psychogenic/analogmuxkit/docs/images/passgates_rdson.png

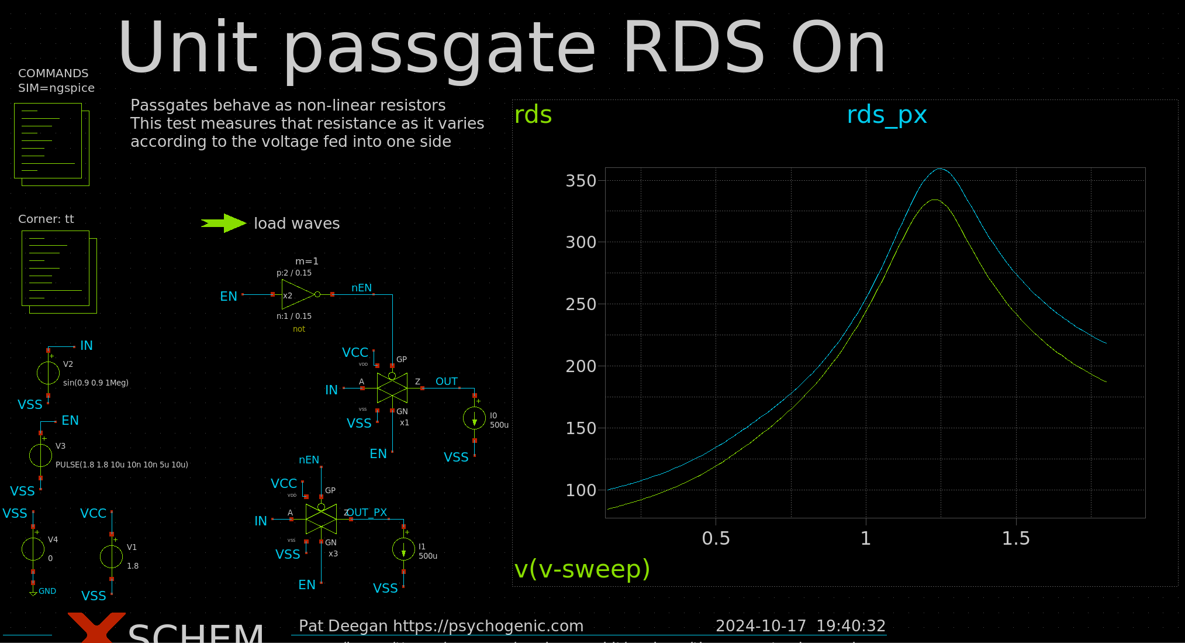
docs/images/passgates_rdson.png
