psychogenic/analogmuxkit/xschem/extracted/mux4onehot_parax.spice

* NGSPICE file created from mux4onehot_parax.ext - technology: sky130A

.subckt mux4onehot_parax select1 select2 A1 A3 Z1 A2 A4 select0 Z4 Z3 VDD Z2 VSS nselect2
X0 A2.t1 x2.GP2.t4 Z2.t1 VDD.t13 sky130_fd_pr__pfet_01v8_lvt ad=2.9 pd=20.58 as=2.9 ps=20.58 w=10 l=0.35
X1 VDD.t65 a_5275_n4059# a_5275_n4235# VDD.t64 sky130_fd_pr__pfet_01v8_hvt ad=0.0714 pd=0.76 as=0.0609 ps=0.71 w=0.42 l=0.15
X2 A1.t2 x2.GP1.t4 Z1.t2 VDD.t18 sky130_fd_pr__pfet_01v8_lvt ad=2.9 pd=20.58 as=2.9 ps=20.58 w=10 l=0.35
X3 VSS.t65 select0.t0 a_5275_n3507# VSS.t64 sky130_fd_pr__nfet_01v8 ad=0.1092 pd=1.36 as=0.1092 ps=1.36 w=0.42 l=0.15
X4 a_5275_n3683# a_5275_n3507# a_5301_n3555# VSS.t18 sky130_fd_pr__nfet_01v8 ad=0.1092 pd=1.36 as=0.0504 ps=0.66 w=0.42 l=0.15
X5 A4.t2 x2.GP4.t4 Z4.t2 VDD.t30 sky130_fd_pr__pfet_01v8_lvt ad=2.9 pd=20.58 as=2.9 ps=20.58 w=10 l=0.35
X6 VSS.t9 select1.t0 x1.nSEL1 VSS.t8 sky130_fd_pr__nfet_01v8 ad=0.169 pd=1.82 as=0.08775 ps=0.92 w=0.65 l=0.15
X7 VSS.t31 x2.GN2 x2.GP2.t2 VSS.t30 sky130_fd_pr__nfet_01v8 ad=0.169 pd=1.82 as=0.08775 ps=0.92 w=0.65 l=0.15
X8 x1.nSEL0 select0.t1 VSS.t63 VSS.t62 sky130_fd_pr__nfet_01v8 ad=0.08775 pd=0.92 as=0.169 ps=1.82 w=0.65 l=0.15
X9 VSS.t15 a_5275_n4651# x2.GN1.t0 VSS.t14 sky130_fd_pr__nfet_01v8 ad=0.1118 pd=1.04 as=0.182 ps=1.86 w=0.65 l=0.15
X10 VDD.t17 select0.t2 x1.nSEL0 VDD.t16 sky130_fd_pr__pfet_01v8_hvt ad=0.26 pd=2.52 as=0.135 ps=1.27 w=1 l=0.15
X11 x2.GP1.t2 x2.GN1.t2 VSS.t2 VSS.t1 sky130_fd_pr__nfet_01v8 ad=0.08775 pd=0.92 as=0.169 ps=1.82 w=0.65 l=0.15
X12 VSS.t25 x2.GN1.t3 x2.GP1.t3 VSS.t24 sky130_fd_pr__nfet_01v8 ad=0.169 pd=1.82 as=0.08775 ps=0.92 w=0.65 l=0.15
X13 x2.GP4.t1 x2.GN4.t2 VDD.t22 VDD.t21 sky130_fd_pr__pfet_01v8_hvt ad=0.135 pd=1.27 as=0.26 ps=2.52 w=1 l=0.15
X14 VDD.t15 x2.GN4.t3 x2.GP4.t0 VDD.t14 sky130_fd_pr__pfet_01v8_hvt ad=0.26 pd=2.52 as=0.135 ps=1.27 w=1 l=0.15
X15 a_5275_n4059# select1.t1 VDD.t2 VDD.t1 sky130_fd_pr__pfet_01v8_hvt ad=0.1092 pd=1.36 as=0.0714 ps=0.76 w=0.42 l=0.15
X16 VSS.t49 VDD.t71 VSS.t48 VSS.t47 sky130_fd_pr__nfet_01v8 ad=0.143 pd=1.62 as=0 ps=0 w=0.55 l=1.05
X17 a_5301_n4107# select0.t3 VSS.t61 VSS.t60 sky130_fd_pr__nfet_01v8 ad=0.0504 pd=0.66 as=0.1013 ps=0.99 w=0.42 l=0.15
X18 VSS.t13 a_5275_n4235# x2.GN2 VSS.t12 sky130_fd_pr__nfet_01v8 ad=0.1013 pd=0.99 as=0.169 ps=1.82 w=0.65 l=0.15
X19 a_5275_n4651# x1.nSEL1 VDD.t27 VDD.t26 sky130_fd_pr__pfet_01v8_hvt ad=0.0567 pd=0.69 as=0.16655 ps=1.39 w=0.42 l=0.15
X20 VSS.t46 VDD.t72 VSS.t45 VSS.t44 sky130_fd_pr__nfet_01v8 ad=0.143 pd=1.62 as=0 ps=0 w=0.55 l=1.05
X21 a_5275_n3507# select0.t4 VDD.t44 VDD.t43 sky130_fd_pr__pfet_01v8_hvt ad=0.1092 pd=1.36 as=0.0714 ps=0.76 w=0.42 l=0.15
X22 a_5275_n4235# select0.t5 VDD.t52 VDD.t51 sky130_fd_pr__pfet_01v8_hvt ad=0.0609 pd=0.71 as=0.2279 ps=1.74 w=0.42 l=0.15
X23 VDD.t54 x1.nSEL0 a_5275_n4651# VDD.t53 sky130_fd_pr__pfet_01v8_hvt ad=0.1176 pd=1.4 as=0.0567 ps=0.69 w=0.42 l=0.15
X24 VDD.t34 a_5275_n3507# a_5275_n3683# VDD.t33 sky130_fd_pr__pfet_01v8_hvt ad=0.0714 pd=0.76 as=0.0609 ps=0.71 w=0.42 l=0.15
X25 VDD.t42 a_5275_n3683# x2.GN3 VDD.t41 sky130_fd_pr__pfet_01v8_hvt ad=0.2279 pd=1.74 as=0.26 ps=2.52 w=1 l=0.15
X26 VSS.t67 a_5275_n2995# x2.GN4.t0 VSS.t66 sky130_fd_pr__nfet_01v8 ad=0.1118 pd=1.04 as=0.182 ps=1.86 w=0.65 l=0.15
X27 nselect2.t3 select2.t0 VDD.t36 VDD.t35 sky130_fd_pr__pfet_01v8_hvt ad=0.135 pd=1.27 as=0.26 ps=2.52 w=1 l=0.15
X28 A3.t1 x2.GP3 Z3.t1 VDD.t0 sky130_fd_pr__pfet_01v8_lvt ad=2.9 pd=20.58 as=2.9 ps=20.58 w=10 l=0.35
X29 VSS.t59 select0.t6 x1.nSEL0 VSS.t58 sky130_fd_pr__nfet_01v8 ad=0.169 pd=1.82 as=0.08775 ps=0.92 w=0.65 l=0.15
X30 Z3.t3 x2.GN3 A3.t3 VSS.t7 sky130_fd_pr__nfet_01v8_lvt ad=2.32 pd=16.58 as=2.32 ps=16.58 w=8 l=0.35
X31 Z3.t2 x2.GN3 A3.t2 VSS.t7 sky130_fd_pr__nfet_01v8_lvt ad=2.32 pd=16.58 as=2.32 ps=16.58 w=8 l=0.35
X32 VDD.t40 select2.t1 nselect2.t2 VDD.t39 sky130_fd_pr__pfet_01v8_hvt ad=0.26 pd=2.52 as=0.135 ps=1.27 w=1 l=0.15
X33 x2.GP4.t3 x2.GN4.t4 VSS.t55 VSS.t54 sky130_fd_pr__nfet_01v8 ad=0.08775 pd=0.92 as=0.169 ps=1.82 w=0.65 l=0.15
X34 x2.GP3 x2.GN3 VDD.t12 VDD.t11 sky130_fd_pr__pfet_01v8_hvt ad=0.135 pd=1.27 as=0.26 ps=2.52 w=1 l=0.15
X35 x1.nSEL1 select1.t2 VDD.t4 VDD.t3 sky130_fd_pr__pfet_01v8_hvt ad=0.135 pd=1.27 as=0.26 ps=2.52 w=1 l=0.15
X36 x2.GP2.t0 x2.GN2 VDD.t58 VDD.t57 sky130_fd_pr__pfet_01v8_hvt ad=0.135 pd=1.27 as=0.26 ps=2.52 w=1 l=0.15
X37 VDD.t25 VSS.t68 VDD.t24 VDD.t23 sky130_fd_pr__pfet_01v8_hvt ad=0.2262 pd=2.26 as=0 ps=0 w=0.87 l=1.05
X38 VSS.t17 x2.GN4.t5 x2.GP4.t2 VSS.t16 sky130_fd_pr__nfet_01v8 ad=0.169 pd=1.82 as=0.08775 ps=0.92 w=0.65 l=0.15
X39 VSS.t43 VDD.t73 VSS.t42 VSS.t41 sky130_fd_pr__nfet_01v8 ad=0.143 pd=1.62 as=0 ps=0 w=0.55 l=1.05
X40 a_5329_n4513# x1.nSEL1 VSS.t11 VSS.t10 sky130_fd_pr__nfet_01v8 ad=0.0567 pd=0.69 as=0.1118 ps=1.04 w=0.42 l=0.15
X41 VDD.t61 VSS.t69 VDD.t60 VDD.t59 sky130_fd_pr__pfet_01v8_hvt ad=0.2262 pd=2.26 as=0 ps=0 w=0.87 l=1.05
X42 a_5275_n4651# x1.nSEL0 a_5329_n4513# VSS.t26 sky130_fd_pr__nfet_01v8 ad=0.1176 pd=1.4 as=0.0567 ps=0.69 w=0.42 l=0.15
X43 A4.t1 x2.GP4.t5 Z4.t1 VDD.t30 sky130_fd_pr__pfet_01v8_lvt ad=2.9 pd=20.58 as=2.9 ps=20.58 w=10 l=0.35
X44 a_5275_n2995# select0.t7 VDD.t38 VDD.t37 sky130_fd_pr__pfet_01v8_hvt ad=0.0567 pd=0.69 as=0.16655 ps=1.39 w=0.42 l=0.15
X45 VDD.t10 x2.GN3 x2.GP3 VDD.t9 sky130_fd_pr__pfet_01v8_hvt ad=0.26 pd=2.52 as=0.135 ps=1.27 w=1 l=0.15
X46 VDD.t32 a_5275_n4651# x2.GN1.t1 VDD.t31 sky130_fd_pr__pfet_01v8_hvt ad=0.16655 pd=1.39 as=0.475 ps=2.95 w=1 l=0.15
X47 Z4.t0 x2.GN4.t6 A4.t0 VSS.t19 sky130_fd_pr__nfet_01v8_lvt ad=2.32 pd=16.58 as=2.32 ps=16.58 w=8 l=0.35
X48 VSS.t40 VDD.t74 VSS.t39 VSS.t38 sky130_fd_pr__nfet_01v8 ad=0.143 pd=1.62 as=0 ps=0 w=0.55 l=1.05
X49 Z4.t3 x2.GN4.t7 A4.t3 VSS.t19 sky130_fd_pr__nfet_01v8_lvt ad=2.32 pd=16.58 as=2.32 ps=16.58 w=8 l=0.35
X50 VDD.t20 select1.t3 a_5275_n2995# VDD.t19 sky130_fd_pr__pfet_01v8_hvt ad=0.1176 pd=1.4 as=0.0567 ps=0.69 w=0.42 l=0.15
X51 a_5275_n3683# select1.t4 VDD.t47 VDD.t9 sky130_fd_pr__pfet_01v8_hvt ad=0.0609 pd=0.71 as=0.2279 ps=1.74 w=0.42 l=0.15
X52 nselect2.t1 select2.t2 VSS.t53 VSS.t52 sky130_fd_pr__nfet_01v8 ad=0.08775 pd=0.92 as=0.169 ps=1.82 w=0.65 l=0.15
X53 a_5275_n4235# a_5275_n4059# a_5301_n4107# VSS.t36 sky130_fd_pr__nfet_01v8 ad=0.1092 pd=1.36 as=0.0504 ps=0.66 w=0.42 l=0.15
X54 VSS.t51 select2.t3 nselect2.t0 VSS.t50 sky130_fd_pr__nfet_01v8 ad=0.169 pd=1.82 as=0.08775 ps=0.92 w=0.65 l=0.15
X55 x2.GP3 x2.GN3 VSS.t6 VSS.t5 sky130_fd_pr__nfet_01v8 ad=0.08775 pd=0.92 as=0.169 ps=1.82 w=0.65 l=0.15
X56 VDD.t50 VSS.t70 VDD.t49 VDD.t48 sky130_fd_pr__pfet_01v8_hvt ad=0.2262 pd=2.26 as=0 ps=0 w=0.87 l=1.05
X57 A2.t0 x2.GP2.t5 Z2.t0 VDD.t13 sky130_fd_pr__pfet_01v8_lvt ad=2.9 pd=20.58 as=2.9 ps=20.58 w=10 l=0.35
X58 VDD.t46 select1.t5 x1.nSEL1 VDD.t45 sky130_fd_pr__pfet_01v8_hvt ad=0.26 pd=2.52 as=0.135 ps=1.27 w=1 l=0.15
X59 x1.nSEL1 select1.t6 VSS.t35 VSS.t34 sky130_fd_pr__nfet_01v8 ad=0.08775 pd=0.92 as=0.169 ps=1.82 w=0.65 l=0.15
X60 x2.GP2.t3 x2.GN2 VSS.t29 VSS.t28 sky130_fd_pr__nfet_01v8 ad=0.08775 pd=0.92 as=0.169 ps=1.82 w=0.65 l=0.15
X61 VDD.t29 a_5275_n4235# x2.GN2 VDD.t28 sky130_fd_pr__pfet_01v8_hvt ad=0.2279 pd=1.74 as=0.26 ps=2.52 w=1 l=0.15
X62 Z2.t2 x2.GN2 A2.t3 VSS.t27 sky130_fd_pr__nfet_01v8_lvt ad=2.32 pd=16.58 as=2.32 ps=16.58 w=8 l=0.35
X63 a_5329_n2857# select0.t8 VSS.t57 VSS.t56 sky130_fd_pr__nfet_01v8 ad=0.0567 pd=0.69 as=0.1118 ps=1.04 w=0.42 l=0.15
X64 A1.t1 x2.GP1.t5 Z1.t1 VDD.t18 sky130_fd_pr__pfet_01v8_lvt ad=2.9 pd=20.58 as=2.9 ps=20.58 w=10 l=0.35
X65 Z2.t3 x2.GN2 A2.t2 VSS.t27 sky130_fd_pr__nfet_01v8_lvt ad=2.32 pd=16.58 as=2.32 ps=16.58 w=8 l=0.35
X66 VDD.t70 a_5275_n2995# x2.GN4.t1 VDD.t69 sky130_fd_pr__pfet_01v8_hvt ad=0.16655 pd=1.39 as=0.475 ps=2.95 w=1 l=0.15
X67 VDD.t68 VSS.t71 VDD.t67 VDD.t66 sky130_fd_pr__pfet_01v8_hvt ad=0.2262 pd=2.26 as=0 ps=0 w=0.87 l=1.05
X68 VSS.t4 x2.GN3 x2.GP3 VSS.t3 sky130_fd_pr__nfet_01v8 ad=0.169 pd=1.82 as=0.08775 ps=0.92 w=0.65 l=0.15
X69 VDD.t56 x2.GN2 x2.GP2.t1 VDD.t55 sky130_fd_pr__pfet_01v8_hvt ad=0.26 pd=2.52 as=0.135 ps=1.27 w=1 l=0.15
X70 x1.nSEL0 select0.t9 VDD.t63 VDD.t62 sky130_fd_pr__pfet_01v8_hvt ad=0.135 pd=1.27 as=0.26 ps=2.52 w=1 l=0.15
X71 Z1.t3 x2.GN1.t4 A1.t3 VSS.t0 sky130_fd_pr__nfet_01v8_lvt ad=2.32 pd=16.58 as=2.32 ps=16.58 w=8 l=0.35
X72 x2.GP1.t1 x2.GN1.t5 VDD.t8 VDD.t7 sky130_fd_pr__pfet_01v8_hvt ad=0.135 pd=1.27 as=0.26 ps=2.52 w=1 l=0.15
X73 Z1.t0 x2.GN1.t6 A1.t0 VSS.t0 sky130_fd_pr__nfet_01v8_lvt ad=2.32 pd=16.58 as=2.32 ps=16.58 w=8 l=0.35
X74 a_5275_n2995# select1.t7 a_5329_n2857# VSS.t37 sky130_fd_pr__nfet_01v8 ad=0.1176 pd=1.4 as=0.0567 ps=0.69 w=0.42 l=0.15
X75 a_5301_n3555# select1.t8 VSS.t23 VSS.t22 sky130_fd_pr__nfet_01v8 ad=0.0504 pd=0.66 as=0.1013 ps=0.99 w=0.42 l=0.15
X76 VSS.t21 a_5275_n3683# x2.GN3 VSS.t20 sky130_fd_pr__nfet_01v8 ad=0.1013 pd=0.99 as=0.169 ps=1.82 w=0.65 l=0.15
X77 VSS.t33 select1.t9 a_5275_n4059# VSS.t32 sky130_fd_pr__nfet_01v8 ad=0.1092 pd=1.36 as=0.1092 ps=1.36 w=0.42 l=0.15
X78 VDD.t6 x2.GN1.t7 x2.GP1.t0 VDD.t5 sky130_fd_pr__pfet_01v8_hvt ad=0.26 pd=2.52 as=0.135 ps=1.27 w=1 l=0.15
X79 A3.t0 x2.GP3 Z3.t0 VDD.t0 sky130_fd_pr__pfet_01v8_lvt ad=2.9 pd=20.58 as=2.9 ps=20.58 w=10 l=0.35
R0 x2.GP2.n4 x2.GP2.t4 450.938
R1 x2.GP2.n4 x2.GP2.t5 445.666
R2 x2.GP2.n5 x2.GP2.n3 195.958
R3 x2.GP2.n1 x2.GP2.n0 101.49
R4 x2.GP2.n3 x2.GP2.t1 26.5955
R5 x2.GP2.n3 x2.GP2.t0 26.5955
R6 x2.GP2.n0 x2.GP2.t2 24.9236
R7 x2.GP2.n0 x2.GP2.t3 24.9236
R8 x1.gpo1 x2.x2.GP 13.129
R9 x2.GP2.n5 x1.gpo1 11.995
R10 x2.GP2.n2 x1.x12.Y 10.7525
R11 x1.x12.Y x2.GP2.n5 7.96524
R12 x2.GP2.n2 x1.x12.Y 6.6565
R13 x1.x12.Y x2.GP2.n2 5.04292
R14 x2.x2.GP x2.GP2.n4 2.94361
R15 x1.x12.Y x2.GP2.n1 2.5605
R16 x2.GP2.n1 x1.x12.Y 1.93989
R17 Z2.n1 Z2.t0 23.6581
R18 Z2.n3 Z2.t1 23.3739
R19 Z2.n1 Z2.t2 10.7528
R20 Z2.n0 Z2.t3 10.6417
R21 Z2.n2 Z2.n1 1.30064
R22 Z2.n5 Z2.n4 0.936641
R23 Z2.n3 Z2.n2 0.726502
R24 Z2.n2 Z2.n0 0.512491
R25 Z2.n4 Z2.n0 0.359663
R26 Z2.n4 Z2.n3 0.216071
R27 Z2.n5 Z2 0.0776605
R28 Z2 Z2.n5 0.0561931
R29 A2.n1 A2.t1 26.3998
R30 A2.n1 A2.t0 23.5483
R31 A2.n0 A2.t2 12.7127
R32 A2.n0 A2.t3 10.8578
R33 A2.n2 A2.n1 3.12177
R34 A2.n2 A2.n0 1.81453
R35 A2.n3 A2.n2 1.1255
R36 A2.n3 A2 0.219402
R37 A2 A2.n3 0.0655
R38 VDD.n57 VDD.n55 8629.41
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
R702 VSS.n111 VSS.n106 9.70901
R703 VSS.n123 VSS.n122 9.70901
R704 VSS.n69 VSS.n68 9.70901
R705 VSS.n127 VSS.n85 9.41227
R706 VSS.n166 VSS.n165 9.3005
R707 VSS.n170 VSS.n169 9.3005
R708 VSS.n174 VSS.n61 9.3005
R709 VSS.n178 VSS.n59 9.3005
R710 VSS.n92 VSS.n58 9.3005
R711 VSS.n97 VSS.n91 9.3005
R712 VSS.n102 VSS.n101 9.3005
R713 VSS.n120 VSS.n119 9.3005
R714 VSS.n121 VSS.n87 9.3005
R715 VSS.n100 VSS.n90 9.3005
R716 VSS.n99 VSS.n98 9.3005
R717 VSS.n96 VSS.n95 9.3005
R718 VSS.n94 VSS.n93 9.3005
R719 VSS.n177 VSS.n60 9.3005
R720 VSS.n176 VSS.n175 9.3005
R721 VSS.n173 VSS.n172 9.3005
R722 VSS.n171 VSS.n62 9.3005
R723 VSS.n114 VSS.n113 9.3005
R724 VSS.n110 VSS.n105 9.3005
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
