psychogenic/analogmuxkit/xschem/extracted/mux4to1_parax.spice

* NGSPICE file created from mux4to1_parax.ext - technology: sky130A

.subckt mux4to1_parax A2 A4 A1 A3 Z select1 VDD select0 nselect2 VSS
X0 VSS.t31 mux4onehot_0.x2.GN1.t2 mux4onehot_0.x2.GP1.t2 VSS.t30 sky130_fd_pr__nfet_01v8 ad=0.169 pd=1.82 as=0.08775 ps=0.92 w=0.65 l=0.15
X1 VDD.t27 mux4onehot_0.x1.nSEL0 a_617_3403# VDD.t26 sky130_fd_pr__pfet_01v8_hvt ad=0.1176 pd=1.4 as=0.0567 ps=0.69 w=0.42 l=0.15
X2 Z.t13 mux4onehot_0.x2.GN3 A3.t2 VSS.t53 sky130_fd_pr__nfet_01v8_lvt ad=2.32 pd=16.58 as=2.32 ps=16.58 w=8 l=0.35
X3 VDD.t36 mux4onehot_0.x2.GN2 mux4onehot_0.x2.GP2.t3 VDD.t35 sky130_fd_pr__pfet_01v8_hvt ad=0.26 pd=2.52 as=0.135 ps=1.27 w=1 l=0.15
X4 a_643_4499# select1.t0 VSS.t67 VSS.t66 sky130_fd_pr__nfet_01v8 ad=0.0504 pd=0.66 as=0.1013 ps=0.99 w=0.42 l=0.15
X5 VSS.t4 VDD.t71 VSS.t3 VSS.t2 sky130_fd_pr__nfet_01v8 ad=0.143 pd=1.62 as=0 ps=0 w=0.55 l=1.05
X6 A4.t2 mux4onehot_0.x2.GP4.t4 Z.t1 VDD.t21 sky130_fd_pr__pfet_01v8_lvt ad=2.9 pd=20.58 as=2.9 ps=20.58 w=10 l=0.35
X7 VDD.t23 mux4onehot_0.x2.GN4.t2 mux4onehot_0.x2.GP4.t2 VDD.t22 sky130_fd_pr__pfet_01v8_hvt ad=0.26 pd=2.52 as=0.135 ps=1.27 w=1 l=0.15
X8 mux4onehot_0.x2.GP3 mux4onehot_0.x2.GN3 VDD.t54 VDD.t53 sky130_fd_pr__pfet_01v8_hvt ad=0.135 pd=1.27 as=0.26 ps=2.52 w=1 l=0.15
X9 mux4onehot_0.x2.GP2.t2 mux4onehot_0.x2.GN2 VDD.t34 VDD.t33 sky130_fd_pr__pfet_01v8_hvt ad=0.135 pd=1.27 as=0.26 ps=2.52 w=1 l=0.15
X10 a_617_3403# mux4onehot_0.x1.nSEL1 VDD.t50 VDD.t49 sky130_fd_pr__pfet_01v8_hvt ad=0.0567 pd=0.69 as=0.16655 ps=1.39 w=0.42 l=0.15
X11 VDD.t14 VSS.t68 VDD.t13 VDD.t12 sky130_fd_pr__pfet_01v8_hvt ad=0.2262 pd=2.26 as=0 ps=0 w=0.87 l=1.05
X12 a_617_3403# mux4onehot_0.x1.nSEL0 a_671_3541# VSS.t19 sky130_fd_pr__nfet_01v8 ad=0.1176 pd=1.4 as=0.0567 ps=0.69 w=0.42 l=0.15
X13 A3.t0 mux4onehot_0.x2.GP3 Z.t11 VDD.t51 sky130_fd_pr__pfet_01v8_lvt ad=2.9 pd=20.58 as=2.9 ps=20.58 w=10 l=0.35
X14 VDD.t48 a_617_4547# a_617_4371# VDD.t47 sky130_fd_pr__pfet_01v8_hvt ad=0.0714 pd=0.76 as=0.0609 ps=0.71 w=0.42 l=0.15
X15 nselect2.t1 mux4onehot_0.select2 VSS.t47 VSS.t46 sky130_fd_pr__nfet_01v8 ad=0.08775 pd=0.92 as=0.169 ps=1.82 w=0.65 l=0.15
X16 VSS.t24 select0.t0 mux4onehot_0.x1.nSEL0 VSS.t23 sky130_fd_pr__nfet_01v8 ad=0.169 pd=1.82 as=0.08775 ps=0.92 w=0.65 l=0.15
X17 a_617_4547# select0.t1 VDD.t25 VDD.t24 sky130_fd_pr__pfet_01v8_hvt ad=0.1092 pd=1.36 as=0.0714 ps=0.76 w=0.42 l=0.15
X18 VDD.t46 a_617_4371# mux4onehot_0.x2.GN3 VDD.t45 sky130_fd_pr__pfet_01v8_hvt ad=0.2279 pd=1.74 as=0.26 ps=2.52 w=1 l=0.15
X19 a_671_3541# mux4onehot_0.x1.nSEL1 VSS.t52 VSS.t51 sky130_fd_pr__nfet_01v8 ad=0.0567 pd=0.69 as=0.1118 ps=1.04 w=0.42 l=0.15
X20 A4.t1 mux4onehot_0.x2.GP4.t5 Z.t2 VDD.t21 sky130_fd_pr__pfet_01v8_lvt ad=2.9 pd=20.58 as=2.9 ps=20.58 w=10 l=0.35
X21 a_617_3819# a_617_3995# a_643_3947# VSS.t43 sky130_fd_pr__nfet_01v8 ad=0.1092 pd=1.36 as=0.0504 ps=0.66 w=0.42 l=0.15
X22 VDD.t38 a_617_3819# mux4onehot_0.x2.GN2 VDD.t37 sky130_fd_pr__pfet_01v8_hvt ad=0.2279 pd=1.74 as=0.26 ps=2.52 w=1 l=0.15
X23 mux4onehot_0.x1.nSEL0 select0.t2 VSS.t6 VSS.t5 sky130_fd_pr__nfet_01v8 ad=0.08775 pd=0.92 as=0.169 ps=1.82 w=0.65 l=0.15
X24 nselect2.t3 mux4onehot_0.select2 VDD.t44 VDD.t43 sky130_fd_pr__pfet_01v8_hvt ad=0.135 pd=1.27 as=0.26 ps=2.52 w=1 l=0.15
X25 VDD.t11 VSS.t69 VDD.t10 VDD.t9 sky130_fd_pr__pfet_01v8_hvt ad=0.2262 pd=2.26 as=0 ps=0 w=0.87 l=1.05
X26 VSS.t57 mux4onehot_0.x2.GN3 mux4onehot_0.x2.GP3 VSS.t56 sky130_fd_pr__nfet_01v8 ad=0.169 pd=1.82 as=0.08775 ps=0.92 w=0.65 l=0.15
X27 VSS.t1 select1.t1 a_617_3995# VSS.t0 sky130_fd_pr__nfet_01v8 ad=0.1092 pd=1.36 as=0.1092 ps=1.36 w=0.42 l=0.15
X28 VDD.t68 select0.t3 mux4onehot_0.x1.nSEL0 VDD.t67 sky130_fd_pr__pfet_01v8_hvt ad=0.26 pd=2.52 as=0.135 ps=1.27 w=1 l=0.15
X29 mux4onehot_0.x2.GP1.t3 mux4onehot_0.x2.GN1.t3 VSS.t29 VSS.t28 sky130_fd_pr__nfet_01v8 ad=0.08775 pd=0.92 as=0.169 ps=1.82 w=0.65 l=0.15
X30 VSS.t49 a_617_4371# mux4onehot_0.x2.GN3 VSS.t48 sky130_fd_pr__nfet_01v8 ad=0.1013 pd=0.99 as=0.169 ps=1.82 w=0.65 l=0.15
X31 mux4onehot_0.x1.nSEL0 select0.t4 VDD.t18 VDD.t17 sky130_fd_pr__pfet_01v8_hvt ad=0.135 pd=1.27 as=0.26 ps=2.52 w=1 l=0.15
X32 Z.t8 mux4onehot_0.x2.GN2 A2.t1 VSS.t39 sky130_fd_pr__nfet_01v8_lvt ad=2.32 pd=16.58 as=2.32 ps=16.58 w=8 l=0.35
X33 VSS.t42 a_617_3819# mux4onehot_0.x2.GN2 VSS.t41 sky130_fd_pr__nfet_01v8 ad=0.1013 pd=0.99 as=0.169 ps=1.82 w=0.65 l=0.15
X34 mux4onehot_0.x2.GP4.t3 mux4onehot_0.x2.GN4.t3 VDD.t60 VDD.t59 sky130_fd_pr__pfet_01v8_hvt ad=0.135 pd=1.27 as=0.26 ps=2.52 w=1 l=0.15
X35 a_643_3947# select0.t5 VSS.t18 VSS.t17 sky130_fd_pr__nfet_01v8 ad=0.0504 pd=0.66 as=0.1013 ps=0.99 w=0.42 l=0.15
X36 VDD.t62 a_617_5059# mux4onehot_0.x2.GN4.t1 VDD.t61 sky130_fd_pr__pfet_01v8_hvt ad=0.16655 pd=1.39 as=0.475 ps=2.95 w=1 l=0.15
X37 VDD.t32 mux4onehot_0.x2.GN1.t4 mux4onehot_0.x2.GP1.t0 VDD.t31 sky130_fd_pr__pfet_01v8_hvt ad=0.26 pd=2.52 as=0.135 ps=1.27 w=1 l=0.15
X38 A1.t1 mux4onehot_0.x2.GP1.t4 Z.t4 VDD.t28 sky130_fd_pr__pfet_01v8_lvt ad=2.9 pd=20.58 as=2.9 ps=20.58 w=10 l=0.35
X39 a_617_3819# select0.t6 VDD.t20 VDD.t19 sky130_fd_pr__pfet_01v8_hvt ad=0.0609 pd=0.71 as=0.2279 ps=1.74 w=0.42 l=0.15
X40 Z.t6 mux4onehot_0.x2.GN1.t5 A1.t3 VSS.t27 sky130_fd_pr__nfet_01v8_lvt ad=2.32 pd=16.58 as=2.32 ps=16.58 w=8 l=0.35
X41 Z.t7 mux4onehot_0.x2.GN2 A2.t0 VSS.t39 sky130_fd_pr__nfet_01v8_lvt ad=2.32 pd=16.58 as=2.32 ps=16.58 w=8 l=0.35
X42 VSS.t26 select1.t2 mux4onehot_0.x1.nSEL1 VSS.t25 sky130_fd_pr__nfet_01v8 ad=0.169 pd=1.82 as=0.08775 ps=0.92 w=0.65 l=0.15
X43 VSS.t61 a_617_5059# mux4onehot_0.x2.GN4.t0 VSS.t60 sky130_fd_pr__nfet_01v8 ad=0.1118 pd=1.04 as=0.182 ps=1.86 w=0.65 l=0.15
X44 A2.t3 mux4onehot_0.x2.GP2.t4 Z.t14 VDD.t0 sky130_fd_pr__pfet_01v8_lvt ad=2.9 pd=20.58 as=2.9 ps=20.58 w=10 l=0.35
X45 VSS.t38 mux4onehot_0.x2.GN2 mux4onehot_0.x2.GP2.t1 VSS.t37 sky130_fd_pr__nfet_01v8 ad=0.169 pd=1.82 as=0.08775 ps=0.92 w=0.65 l=0.15
X46 Z.t9 mux4onehot_0.x2.GN4.t4 A4.t0 VSS.t40 sky130_fd_pr__nfet_01v8_lvt ad=2.32 pd=16.58 as=2.32 ps=16.58 w=8 l=0.35
X47 VSS.t9 VDD.t72 VSS.t8 VSS.t7 sky130_fd_pr__nfet_01v8 ad=0.143 pd=1.62 as=0 ps=0 w=0.55 l=1.05
X48 VDD.t16 select1.t3 mux4onehot_0.x1.nSEL1 VDD.t15 sky130_fd_pr__pfet_01v8_hvt ad=0.26 pd=2.52 as=0.135 ps=1.27 w=1 l=0.15
X49 mux4onehot_0.x1.nSEL1 select1.t4 VSS.t63 VSS.t62 sky130_fd_pr__nfet_01v8 ad=0.08775 pd=0.92 as=0.169 ps=1.82 w=0.65 l=0.15
X50 VSS.t16 mux4onehot_0.x2.GN4.t5 mux4onehot_0.x2.GP4.t1 VSS.t15 sky130_fd_pr__nfet_01v8 ad=0.169 pd=1.82 as=0.08775 ps=0.92 w=0.65 l=0.15
X51 mux4onehot_0.x2.GP3 mux4onehot_0.x2.GN3 VSS.t55 VSS.t54 sky130_fd_pr__nfet_01v8 ad=0.08775 pd=0.92 as=0.169 ps=1.82 w=0.65 l=0.15
X52 mux4onehot_0.x2.GP2.t0 mux4onehot_0.x2.GN2 VSS.t36 VSS.t35 sky130_fd_pr__nfet_01v8 ad=0.08775 pd=0.92 as=0.169 ps=1.82 w=0.65 l=0.15
X53 VDD.t8 VSS.t70 VDD.t7 VDD.t6 sky130_fd_pr__pfet_01v8_hvt ad=0.2262 pd=2.26 as=0 ps=0 w=0.87 l=1.05
X54 VSS.t13 select0.t7 a_617_4547# VSS.t12 sky130_fd_pr__nfet_01v8 ad=0.1092 pd=1.36 as=0.1092 ps=1.36 w=0.42 l=0.15
X55 a_617_4371# a_617_4547# a_643_4499# VSS.t50 sky130_fd_pr__nfet_01v8 ad=0.1092 pd=1.36 as=0.0504 ps=0.66 w=0.42 l=0.15
X56 VDD.t64 select1.t5 a_617_5059# VDD.t63 sky130_fd_pr__pfet_01v8_hvt ad=0.1176 pd=1.4 as=0.0567 ps=0.69 w=0.42 l=0.15
X57 mux4onehot_0.x1.nSEL1 select1.t6 VDD.t70 VDD.t69 sky130_fd_pr__pfet_01v8_hvt ad=0.135 pd=1.27 as=0.26 ps=2.52 w=1 l=0.15
X58 VDD.t52 mux4onehot_0.x2.GN3 mux4onehot_0.x2.GP3 VDD.t1 sky130_fd_pr__pfet_01v8_hvt ad=0.26 pd=2.52 as=0.135 ps=1.27 w=1 l=0.15
X59 mux4onehot_0.x2.GP1.t1 mux4onehot_0.x2.GN1.t6 VDD.t30 VDD.t29 sky130_fd_pr__pfet_01v8_hvt ad=0.135 pd=1.27 as=0.26 ps=2.52 w=1 l=0.15
X60 A3.t1 mux4onehot_0.x2.GP3 Z.t10 VDD.t51 sky130_fd_pr__pfet_01v8_lvt ad=2.9 pd=20.58 as=2.9 ps=20.58 w=10 l=0.35
X61 a_617_5059# select0.t8 VDD.t66 VDD.t65 sky130_fd_pr__pfet_01v8_hvt ad=0.0567 pd=0.69 as=0.16655 ps=1.39 w=0.42 l=0.15
X62 VSS.t22 VDD.t73 VSS.t21 VSS.t20 sky130_fd_pr__nfet_01v8 ad=0.143 pd=1.62 as=0 ps=0 w=0.55 l=1.05
X63 VDD.t56 a_617_3403# mux4onehot_0.x2.GN1.t1 VDD.t55 sky130_fd_pr__pfet_01v8_hvt ad=0.16655 pd=1.39 as=0.475 ps=2.95 w=1 l=0.15
X64 VDD.t5 VSS.t71 VDD.t4 VDD.t3 sky130_fd_pr__pfet_01v8_hvt ad=0.2262 pd=2.26 as=0 ps=0 w=0.87 l=1.05
X65 Z.t15 mux4onehot_0.x2.GN4.t6 A4.t3 VSS.t40 sky130_fd_pr__nfet_01v8_lvt ad=2.32 pd=16.58 as=2.32 ps=16.58 w=8 l=0.35
X66 a_617_5059# select1.t7 a_671_5197# VSS.t14 sky130_fd_pr__nfet_01v8 ad=0.1176 pd=1.4 as=0.0567 ps=0.69 w=0.42 l=0.15
X67 VSS.t45 mux4onehot_0.select2 nselect2.t0 VSS.t44 sky130_fd_pr__nfet_01v8 ad=0.169 pd=1.82 as=0.08775 ps=0.92 w=0.65 l=0.15
X68 a_617_3995# select1.t8 VDD.t58 VDD.t57 sky130_fd_pr__pfet_01v8_hvt ad=0.1092 pd=1.36 as=0.0714 ps=0.76 w=0.42 l=0.15
X69 VDD.t40 a_617_3995# a_617_3819# VDD.t39 sky130_fd_pr__pfet_01v8_hvt ad=0.0714 pd=0.76 as=0.0609 ps=0.71 w=0.42 l=0.15
X70 a_671_5197# select0.t9 VSS.t65 VSS.t64 sky130_fd_pr__nfet_01v8 ad=0.0567 pd=0.69 as=0.1118 ps=1.04 w=0.42 l=0.15
X71 a_617_4371# select1.t9 VDD.t2 VDD.t1 sky130_fd_pr__pfet_01v8_hvt ad=0.0609 pd=0.71 as=0.2279 ps=1.74 w=0.42 l=0.15
X72 VSS.t59 a_617_3403# mux4onehot_0.x2.GN1.t0 VSS.t58 sky130_fd_pr__nfet_01v8 ad=0.1118 pd=1.04 as=0.182 ps=1.86 w=0.65 l=0.15
X73 Z.t5 mux4onehot_0.x2.GN1.t7 A1.t2 VSS.t27 sky130_fd_pr__nfet_01v8_lvt ad=2.32 pd=16.58 as=2.32 ps=16.58 w=8 l=0.35
X74 A1.t0 mux4onehot_0.x2.GP1.t5 Z.t3 VDD.t28 sky130_fd_pr__pfet_01v8_lvt ad=2.9 pd=20.58 as=2.9 ps=20.58 w=10 l=0.35
X75 VDD.t42 mux4onehot_0.select2 nselect2.t2 VDD.t41 sky130_fd_pr__pfet_01v8_hvt ad=0.26 pd=2.52 as=0.135 ps=1.27 w=1 l=0.15
X76 VSS.t34 VDD.t74 VSS.t33 VSS.t32 sky130_fd_pr__nfet_01v8 ad=0.143 pd=1.62 as=0 ps=0 w=0.55 l=1.05
X77 A2.t2 mux4onehot_0.x2.GP2.t5 Z.t0 VDD.t0 sky130_fd_pr__pfet_01v8_lvt ad=2.9 pd=20.58 as=2.9 ps=20.58 w=10 l=0.35
X78 Z.t12 mux4onehot_0.x2.GN3 A3.t3 VSS.t53 sky130_fd_pr__nfet_01v8_lvt ad=2.32 pd=16.58 as=2.32 ps=16.58 w=8 l=0.35
X79 mux4onehot_0.x2.GP4.t0 mux4onehot_0.x2.GN4.t7 VSS.t11 VSS.t10 sky130_fd_pr__nfet_01v8 ad=0.08775 pd=0.92 as=0.169 ps=1.82 w=0.65 l=0.15
R0 mux4onehot_0.x2.GN1.n1 mux4onehot_0.x2.GN1.t5 377.486
R1 mux4onehot_0.x2.GN1.n1 mux4onehot_0.x2.GN1.t7 374.202
R2 mux4onehot_0.x2.GN1.n7 mux4onehot_0.x2.GN1.t1 339.418
R3 mux4onehot_0.x2.GN1.n0 mux4onehot_0.x2.GN1.t0 274.06
R4 mux4onehot_0.x2.GN1.n4 mux4onehot_0.x2.GN1.t6 212.081
R5 mux4onehot_0.x2.GN1.n3 mux4onehot_0.x2.GN1.t4 212.081
R6 mux4onehot_0.x2.GN1.n5 mux4onehot_0.x2.GN1.n4 182.673
R7 mux4onehot_0.x2.GN1.n4 mux4onehot_0.x2.GN1.t3 139.78
R8 mux4onehot_0.x2.GN1.n3 mux4onehot_0.x2.GN1.t2 139.78
R9 mux4onehot_0.x2.GN1.n4 mux4onehot_0.x2.GN1.n3 61.346
R10 mux4onehot_0.x2.GN1 mux4onehot_0.x2.GN1.n5 15.8606
R11 mux4onehot_0.x2.GN1 mux4onehot_0.x2.GN1.n6 13.8044
R12 mux4onehot_0.x2.GN1.n2 mux4onehot_0.x2.GN1 11.6184
R13 mux4onehot_0.x2.GN1 mux4onehot_0.x2.GN1.n0 11.0989
R14 mux4onehot_0.x2.GN1 mux4onehot_0.x2.GN1.n2 10.8756
R15 mux4onehot_0.x2.GN1.n6 mux4onehot_0.x2.GN1 8.1246
R16 mux4onehot_0.x2.GN1.n8 mux4onehot_0.x2.GN1 6.6565
R17 mux4onehot_0.x2.GN1.n5 mux4onehot_0.x2.GN1 6.4005
R18 mux4onehot_0.x2.GN1.n0 mux4onehot_0.x2.GN1 6.1445
R19 mux4onehot_0.x2.GN1.n2 mux4onehot_0.x2.GN1 4.55738
R20 mux4onehot_0.x2.GN1.n8 mux4onehot_0.x2.GN1.n7 4.0914
R21 mux4onehot_0.x2.GN1 mux4onehot_0.x2.GN1.n8 3.61789
R22 mux4onehot_0.x2.GN1.n6 mux4onehot_0.x2.GN1 3.26325
R23 mux4onehot_0.x2.GN1.n0 mux4onehot_0.x2.GN1 2.86947
R24 mux4onehot_0.x2.GN1 mux4onehot_0.x2.GN1.n1 2.04102
R25 mux4onehot_0.x2.GN1.n7 mux4onehot_0.x2.GN1 1.74382
R26 mux4onehot_0.x2.GP1.n4 mux4onehot_0.x2.GP1.t5 450.938
R27 mux4onehot_0.x2.GP1.n4 mux4onehot_0.x2.GP1.t4 445.666
R28 mux4onehot_0.x2.GP1.n5 mux4onehot_0.x2.GP1.n3 195.832
R29 mux4onehot_0.x2.GP1.n1 mux4onehot_0.x2.GP1.n0 101.49
R30 mux4onehot_0.x2.GP1.n3 mux4onehot_0.x2.GP1.t0 26.5955
R31 mux4onehot_0.x2.GP1.n3 mux4onehot_0.x2.GP1.t1 26.5955
R32 mux4onehot_0.x2.GP1.n0 mux4onehot_0.x2.GP1.t2 24.9236
R33 mux4onehot_0.x2.GP1.n0 mux4onehot_0.x2.GP1.t3 24.9236
R34 mux4onehot_0.x2.GP1.n5 mux4onehot_0.x1.gpo0 11.8923
R35 mux4onehot_0.x1.gpo0 mux4onehot_0.x2.x1.GP 11.5413
R36 mux4onehot_0.x2.GP1.n2 mux4onehot_0.x1.x11.Y 10.7525
R37 mux4onehot_0.x1.x11.Y mux4onehot_0.x2.GP1.n5 8.09215
R38 mux4onehot_0.x2.GP1.n2 mux4onehot_0.x1.x11.Y 6.6565
R39 mux4onehot_0.x1.x11.Y mux4onehot_0.x2.GP1.n2 5.04292
R40 mux4onehot_0.x2.x1.GP mux4onehot_0.x2.GP1.n4 2.90754
R41 mux4onehot_0.x1.x11.Y mux4onehot_0.x2.GP1.n1 2.5605
R42 mux4onehot_0.x2.GP1.n1 mux4onehot_0.x1.x11.Y 1.93989
R43 VSS.n145 VSS.n22 545087
R44 VSS.n40 VSS 11981.2
R45 VSS.n147 VSS.n16 11744.7
R46 VSS.n147 VSS.n17 11744.7
R47 VSS.n151 VSS.n17 11744.7
R48 VSS.n151 VSS.n16 11744.7
R49 VSS.n158 VSS.n10 11744.7
R50 VSS.n154 VSS.n10 11744.7
R51 VSS.n158 VSS.n11 11744.7
R52 VSS.n154 VSS.n11 11744.7
R53 VSS.n167 VSS.n160 11744.7
R54 VSS.n171 VSS.n160 11744.7
R55 VSS.n167 VSS.n161 11744.7
R56 VSS.n171 VSS.n161 11744.7
R57 VSS.n179 VSS.n6 11744.7
R58 VSS.n179 VSS.n7 11744.7
R59 VSS.n178 VSS.n6 11744.7
R60 VSS.n178 VSS.n7 11744.7
R61 VSS.n166 VSS.n8 6117.99
R62 VSS.n153 VSS.n152 6083.44
R63 VSS.n172 VSS.n159 6028.93
R64 VSS.n173 VSS.n9 5416.06
R65 VSS.n174 VSS.n173 5357.62
R66 VSS.n40 VSS.n9 3878.48
R67 VSS.n146 VSS.n145 2026.31
R68 VSS.t12 VSS 1289.66
R69 VSS.n107 VSS.n41 1198.25
R70 VSS.n144 VSS.n143 1198.25
R71 VSS.n133 VSS.n29 1194.5
R72 VSS.n94 VSS.n93 1171.32
R73 VSS.n29 VSS 918.774
R74 VSS VSS.t58 918.774
R75 VSS.t48 VSS.t66 826.054
R76 VSS.t41 VSS.t17 826.054
R77 VSS.t25 VSS.t0 792.337
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
R640 VDD.n69 VDD.n68 9.3005
R641 VDD.n65 VDD.n64 9.3005
R642 VDD.n70 VDD.n57 9.3005
R643 VDD.n72 VDD.n71 9.3005
R644 VDD.n75 VDD.n56 9.3005
R645 VDD.n77 VDD.n76 9.3005
R646 VDD.n80 VDD.n79 9.3005
R647 VDD.n81 VDD.n53 9.3005
R648 VDD.n110 VDD.n109 9.3005
R649 VDD.n115 VDD.n114 9.3005
R650 VDD.n99 VDD.n24 9.3005
R651 VDD.n92 VDD.n90 9.3005
R652 VDD.n43 VDD.n41 9.3005
R653 VDD.n35 VDD.n34 9.3005
R654 VDD.n38 VDD.n30 9.3005
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
