psychogenic/analogmuxkit/xschem/extracted/mux8to1_parax.spice

* NGSPICE file created from mux8to1_parax.ext - technology: sky130A

.subckt mux8to1_parax select1 select2 A1 A3 A2 A4 Z A8 select0 A7 A6 VDD A5 VSS
X0 a_5645_5909# a_5645_6085# a_5671_6037# VSS.t21 sky130_fd_pr__nfet_01v8 ad=0.1092 pd=1.36 as=0.0504 ps=0.66 w=0.42 l=0.15
X1 VSS.t1 select1.t0 a_5645_6085# VSS.t0 sky130_fd_pr__nfet_01v8 ad=0.1092 pd=1.36 as=0.1092 ps=1.36 w=0.42 l=0.15
X2 x5.A select2.t0 Z.t1 VDD.t5 sky130_fd_pr__pfet_01v8_lvt ad=2.9 pd=20.58 as=2.9 ps=20.58 w=10 l=0.35
X3 x4.A x3.GN1.t2 A5.t2 VSS.t22 sky130_fd_pr__nfet_01v8_lvt ad=2.32 pd=16.58 as=2.32 ps=16.58 w=8 l=0.35
X4 VSS.t49 a_5645_6461# x3.GN3 VSS.t48 sky130_fd_pr__nfet_01v8 ad=0.1013 pd=0.99 as=0.169 ps=1.82 w=0.65 l=0.15
X5 x3.GP4.t3 x3.GN4.t2 VSS.t30 VSS.t29 sky130_fd_pr__nfet_01v8 ad=0.08775 pd=0.92 as=0.169 ps=1.82 w=0.65 l=0.15
X6 x5.GN select2.t1 VDD.t4 VDD.t3 sky130_fd_pr__pfet_01v8_hvt ad=0.135 pd=1.27 as=0.26 ps=2.52 w=1 l=0.15
X7 VSS.t63 a_5645_5909# x3.GN2 VSS.t62 sky130_fd_pr__nfet_01v8 ad=0.1013 pd=0.99 as=0.169 ps=1.82 w=0.65 l=0.15
X8 VDD.t78 select0.t0 x1.nSEL0 VDD.t77 sky130_fd_pr__pfet_01v8_hvt ad=0.26 pd=2.52 as=0.135 ps=1.27 w=1 l=0.15
X9 x5.A select2.t2 Z.t0 VDD.t2 sky130_fd_pr__pfet_01v8_lvt ad=2.9 pd=20.58 as=2.9 ps=20.58 w=10 l=0.35
X10 A1.t1 x3.GP1.t4 x5.A VDD.t45 sky130_fd_pr__pfet_01v8_lvt ad=2.9 pd=20.58 as=2.9 ps=20.58 w=10 l=0.35
X11 x5.A x3.GN2 A2.t2 VSS.t31 sky130_fd_pr__nfet_01v8_lvt ad=2.32 pd=16.58 as=2.32 ps=16.58 w=8 l=0.35
X12 VDD.t72 VSS.t76 VDD.t71 VDD.t70 sky130_fd_pr__pfet_01v8_hvt ad=0.2262 pd=2.26 as=0 ps=0 w=0.87 l=1.05
X13 x4.A x5.GN Z.t7 VDD.t76 sky130_fd_pr__pfet_01v8_lvt ad=2.9 pd=20.58 as=2.9 ps=20.58 w=10 l=0.35
X14 x1.nSEL0 select0.t1 VDD.t19 VDD.t18 sky130_fd_pr__pfet_01v8_hvt ad=0.135 pd=1.27 as=0.26 ps=2.52 w=1 l=0.15
X15 x5.A x3.GN4.t3 A4.t1 VSS.t57 sky130_fd_pr__nfet_01v8_lvt ad=2.32 pd=16.58 as=2.32 ps=16.58 w=8 l=0.35
X16 VSS.t41 VDD.t79 VSS.t40 VSS.t39 sky130_fd_pr__nfet_01v8 ad=0.143 pd=1.62 as=0 ps=0 w=0.55 l=1.05
X17 a_5671_6037# select0.t2 VSS.t43 VSS.t42 sky130_fd_pr__nfet_01v8 ad=0.0504 pd=0.66 as=0.1013 ps=0.99 w=0.42 l=0.15
X18 A7.t3 x3.GP3 x4.A VDD.t41 sky130_fd_pr__pfet_01v8_lvt ad=2.9 pd=20.58 as=2.9 ps=20.58 w=10 l=0.35
X19 x4.A x5.GN Z.t6 VDD.t75 sky130_fd_pr__pfet_01v8_lvt ad=2.9 pd=20.58 as=2.9 ps=20.58 w=10 l=0.35
X20 Z.t5 x5.GN x5.A VSS.t74 sky130_fd_pr__nfet_01v8_lvt ad=2.32 pd=16.58 as=2.32 ps=16.58 w=8 l=0.35
X21 A3.t3 x3.GP3 x5.A VDD.t42 sky130_fd_pr__pfet_01v8_lvt ad=2.9 pd=20.58 as=2.9 ps=20.58 w=10 l=0.35
X22 VSS.t56 select1.t1 x1.nSEL1 VSS.t55 sky130_fd_pr__nfet_01v8 ad=0.169 pd=1.82 as=0.08775 ps=0.92 w=0.65 l=0.15
X23 x3.GP4.t1 x3.GN4.t4 VDD.t24 VDD.t23 sky130_fd_pr__pfet_01v8_hvt ad=0.135 pd=1.27 as=0.26 ps=2.52 w=1 l=0.15
X24 Z.t3 select2.t3 x4.A VSS.t75 sky130_fd_pr__nfet_01v8_lvt ad=2.32 pd=16.58 as=2.32 ps=16.58 w=8 l=0.35
X25 VSS.t45 a_5645_7149# x3.GN4.t1 VSS.t44 sky130_fd_pr__nfet_01v8 ad=0.1118 pd=1.04 as=0.182 ps=1.86 w=0.65 l=0.15
X26 VDD.t16 a_5645_6637# a_5645_6461# VDD.t15 sky130_fd_pr__pfet_01v8_hvt ad=0.0714 pd=0.76 as=0.0609 ps=0.71 w=0.42 l=0.15
X27 x4.A x3.GN2 A6.t2 VSS.t36 sky130_fd_pr__nfet_01v8_lvt ad=2.32 pd=16.58 as=2.32 ps=16.58 w=8 l=0.35
X28 a_5645_7149# select1.t2 a_5699_7287# VSS.t64 sky130_fd_pr__nfet_01v8 ad=0.1176 pd=1.4 as=0.0567 ps=0.69 w=0.42 l=0.15
X29 x4.A x3.GN1.t3 A5.t1 VSS.t22 sky130_fd_pr__nfet_01v8_lvt ad=2.32 pd=16.58 as=2.32 ps=16.58 w=8 l=0.35
X30 a_5645_6637# select0.t3 VDD.t28 VDD.t27 sky130_fd_pr__pfet_01v8_hvt ad=0.1092 pd=1.36 as=0.0714 ps=0.76 w=0.42 l=0.15
X31 VSS.t16 x3.GN1.t4 x3.GP1.t3 VSS.t15 sky130_fd_pr__nfet_01v8 ad=0.169 pd=1.82 as=0.08775 ps=0.92 w=0.65 l=0.15
X32 a_5699_7287# select0.t4 VSS.t61 VSS.t60 sky130_fd_pr__nfet_01v8 ad=0.0567 pd=0.69 as=0.1118 ps=1.04 w=0.42 l=0.15
X33 VSS.t68 VDD.t80 VSS.t67 VSS.t66 sky130_fd_pr__nfet_01v8 ad=0.143 pd=1.62 as=0 ps=0 w=0.55 l=1.05
X34 x5.A x3.GN3 A3.t1 VSS.t10 sky130_fd_pr__nfet_01v8_lvt ad=2.32 pd=16.58 as=2.32 ps=16.58 w=8 l=0.35
X35 A8.t3 x3.GP4.t4 x4.A VDD.t22 sky130_fd_pr__pfet_01v8_lvt ad=2.9 pd=20.58 as=2.9 ps=20.58 w=10 l=0.35
X36 A1.t0 x3.GP1.t5 x5.A VDD.t45 sky130_fd_pr__pfet_01v8_lvt ad=2.9 pd=20.58 as=2.9 ps=20.58 w=10 l=0.35
X37 a_5645_6461# a_5645_6637# a_5671_6589# VSS.t17 sky130_fd_pr__nfet_01v8 ad=0.1092 pd=1.36 as=0.0504 ps=0.66 w=0.42 l=0.15
X38 x5.A x3.GN4.t5 A4.t0 VSS.t57 sky130_fd_pr__nfet_01v8_lvt ad=2.32 pd=16.58 as=2.32 ps=16.58 w=8 l=0.35
X39 VSS.t12 x3.GN3 x3.GP3 VSS.t11 sky130_fd_pr__nfet_01v8 ad=0.169 pd=1.82 as=0.08775 ps=0.92 w=0.65 l=0.15
X40 x3.GP1.t2 x3.GN1.t5 VSS.t6 VSS.t5 sky130_fd_pr__nfet_01v8 ad=0.08775 pd=0.92 as=0.169 ps=1.82 w=0.65 l=0.15
X41 VSS.t24 select0.t5 a_5645_6637# VSS.t23 sky130_fd_pr__nfet_01v8 ad=0.1092 pd=1.36 as=0.1092 ps=1.36 w=0.42 l=0.15
X42 Z.t4 x5.GN x5.A VSS.t73 sky130_fd_pr__nfet_01v8_lvt ad=2.32 pd=16.58 as=2.32 ps=16.58 w=8 l=0.35
X43 VDD.t58 select1.t3 x1.nSEL1 VDD.t57 sky130_fd_pr__pfet_01v8_hvt ad=0.26 pd=2.52 as=0.135 ps=1.27 w=1 l=0.15
X44 VDD.t56 select1.t4 a_5645_7149# VDD.t55 sky130_fd_pr__pfet_01v8_hvt ad=0.1176 pd=1.4 as=0.0567 ps=0.69 w=0.42 l=0.15
X45 A5.t3 x3.GP1.t6 x4.A VDD.t6 sky130_fd_pr__pfet_01v8_lvt ad=2.9 pd=20.58 as=2.9 ps=20.58 w=10 l=0.35
X46 VDD.t69 VSS.t77 VDD.t68 VDD.t67 sky130_fd_pr__pfet_01v8_hvt ad=0.2262 pd=2.26 as=0 ps=0 w=0.87 l=1.05
X47 Z.t2 select2.t4 x4.A VSS.t65 sky130_fd_pr__nfet_01v8_lvt ad=2.32 pd=16.58 as=2.32 ps=16.58 w=8 l=0.35
X48 VDD.t38 a_5645_5493# x3.GN1.t0 VDD.t37 sky130_fd_pr__pfet_01v8_hvt ad=0.16655 pd=1.39 as=0.475 ps=2.95 w=1 l=0.15
X49 a_5645_7149# select0.t6 VDD.t49 VDD.t48 sky130_fd_pr__pfet_01v8_hvt ad=0.0567 pd=0.69 as=0.16655 ps=1.39 w=0.42 l=0.15
X50 VDD.t74 x3.GN1.t6 x3.GP1.t1 VDD.t73 sky130_fd_pr__pfet_01v8_hvt ad=0.26 pd=2.52 as=0.135 ps=1.27 w=1 l=0.15
X51 x4.A x3.GN3 A7.t1 VSS.t7 sky130_fd_pr__nfet_01v8_lvt ad=2.32 pd=16.58 as=2.32 ps=16.58 w=8 l=0.35
X52 x4.A x3.GN2 A6.t1 VSS.t36 sky130_fd_pr__nfet_01v8_lvt ad=2.32 pd=16.58 as=2.32 ps=16.58 w=8 l=0.35
X53 A4.t3 x3.GP4.t5 x5.A VDD.t10 sky130_fd_pr__pfet_01v8_lvt ad=2.9 pd=20.58 as=2.9 ps=20.58 w=10 l=0.35
X54 VSS.t70 select2.t5 x5.GN VSS.t69 sky130_fd_pr__nfet_01v8 ad=0.169 pd=1.82 as=0.08775 ps=0.92 w=0.65 l=0.15
X55 a_5645_5493# x1.nSEL0 a_5699_5631# VSS.t54 sky130_fd_pr__nfet_01v8 ad=0.1176 pd=1.4 as=0.0567 ps=0.69 w=0.42 l=0.15
X56 x1.nSEL1 select1.t5 VSS.t38 VSS.t37 sky130_fd_pr__nfet_01v8 ad=0.08775 pd=0.92 as=0.169 ps=1.82 w=0.65 l=0.15
X57 x5.A x3.GN1.t7 A1.t3 VSS.t26 sky130_fd_pr__nfet_01v8_lvt ad=2.32 pd=16.58 as=2.32 ps=16.58 w=8 l=0.35
X58 VDD.t14 x3.GN3 x3.GP3 VDD.t13 sky130_fd_pr__pfet_01v8_hvt ad=0.26 pd=2.52 as=0.135 ps=1.27 w=1 l=0.15
X59 x3.GP1.t0 x3.GN1.t8 VDD.t26 VDD.t25 sky130_fd_pr__pfet_01v8_hvt ad=0.135 pd=1.27 as=0.26 ps=2.52 w=1 l=0.15
X60 a_5645_5909# select0.t7 VDD.t9 VDD.t8 sky130_fd_pr__pfet_01v8_hvt ad=0.0609 pd=0.71 as=0.2279 ps=1.74 w=0.42 l=0.15
X61 x5.A x3.GN3 A3.t0 VSS.t10 sky130_fd_pr__nfet_01v8_lvt ad=2.32 pd=16.58 as=2.32 ps=16.58 w=8 l=0.35
X62 A2.t3 x3.GP2.t4 x5.A VDD.t17 sky130_fd_pr__pfet_01v8_lvt ad=2.9 pd=20.58 as=2.9 ps=20.58 w=10 l=0.35
X63 x5.A x3.GN1.t9 A1.t2 VSS.t26 sky130_fd_pr__nfet_01v8_lvt ad=2.32 pd=16.58 as=2.32 ps=16.58 w=8 l=0.35
X64 A3.t2 x3.GP3 x5.A VDD.t42 sky130_fd_pr__pfet_01v8_lvt ad=2.9 pd=20.58 as=2.9 ps=20.58 w=10 l=0.35
X65 VDD.t66 VSS.t78 VDD.t65 VDD.t64 sky130_fd_pr__pfet_01v8_hvt ad=0.2262 pd=2.26 as=0 ps=0 w=0.87 l=1.05
X66 a_5699_5631# x1.nSEL1 VSS.t53 VSS.t52 sky130_fd_pr__nfet_01v8 ad=0.0567 pd=0.69 as=0.1118 ps=1.04 w=0.42 l=0.15
X67 VSS.t20 VDD.t81 VSS.t19 VSS.t18 sky130_fd_pr__nfet_01v8 ad=0.143 pd=1.62 as=0 ps=0 w=0.55 l=1.05
X68 x4.A x3.GN4.t6 A8.t1 VSS.t25 sky130_fd_pr__nfet_01v8_lvt ad=2.32 pd=16.58 as=2.32 ps=16.58 w=8 l=0.35
X69 VDD.t40 a_5645_6461# x3.GN3 VDD.t39 sky130_fd_pr__pfet_01v8_hvt ad=0.2279 pd=1.74 as=0.26 ps=2.52 w=1 l=0.15
X70 VSS.t35 x3.GN2 x3.GP2.t3 VSS.t34 sky130_fd_pr__nfet_01v8 ad=0.169 pd=1.82 as=0.08775 ps=0.92 w=0.65 l=0.15
X71 A6.t0 x3.GP2.t5 x4.A VDD.t7 sky130_fd_pr__pfet_01v8_lvt ad=2.9 pd=20.58 as=2.9 ps=20.58 w=10 l=0.35
X72 A5.t0 x3.GP1.t7 x4.A VDD.t6 sky130_fd_pr__pfet_01v8_lvt ad=2.9 pd=20.58 as=2.9 ps=20.58 w=10 l=0.35
X73 VDD.t47 x1.nSEL0 a_5645_5493# VDD.t46 sky130_fd_pr__pfet_01v8_hvt ad=0.1176 pd=1.4 as=0.0567 ps=0.69 w=0.42 l=0.15
X74 x3.GP2.t2 x3.GN2 VSS.t33 VSS.t32 sky130_fd_pr__nfet_01v8 ad=0.08775 pd=0.92 as=0.169 ps=1.82 w=0.65 l=0.15
X75 VSS.t14 x3.GN4.t7 x3.GP4.t2 VSS.t13 sky130_fd_pr__nfet_01v8 ad=0.169 pd=1.82 as=0.08775 ps=0.92 w=0.65 l=0.15
X76 VDD.t60 a_5645_5909# x3.GN2 VDD.t59 sky130_fd_pr__pfet_01v8_hvt ad=0.2279 pd=1.74 as=0.26 ps=2.52 w=1 l=0.15
X77 x3.GP3 x3.GN3 VSS.t9 VSS.t8 sky130_fd_pr__nfet_01v8 ad=0.08775 pd=0.92 as=0.169 ps=1.82 w=0.65 l=0.15
X78 A7.t2 x3.GP3 x4.A VDD.t41 sky130_fd_pr__pfet_01v8_lvt ad=2.9 pd=20.58 as=2.9 ps=20.58 w=10 l=0.35
X79 x1.nSEL1 select1.t6 VDD.t54 VDD.t53 sky130_fd_pr__pfet_01v8_hvt ad=0.135 pd=1.27 as=0.26 ps=2.52 w=1 l=0.15
X80 VDD.t1 select2.t6 x5.GN VDD.t0 sky130_fd_pr__pfet_01v8_hvt ad=0.26 pd=2.52 as=0.135 ps=1.27 w=1 l=0.15
X81 a_5671_6589# select1.t7 VSS.t72 VSS.t71 sky130_fd_pr__nfet_01v8 ad=0.0504 pd=0.66 as=0.1013 ps=0.99 w=0.42 l=0.15
X82 x4.A x3.GN3 A7.t0 VSS.t7 sky130_fd_pr__nfet_01v8_lvt ad=2.32 pd=16.58 as=2.32 ps=16.58 w=8 l=0.35
X83 A8.t2 x3.GP4.t6 x4.A VDD.t22 sky130_fd_pr__pfet_01v8_lvt ad=2.9 pd=20.58 as=2.9 ps=20.58 w=10 l=0.35
X84 A4.t2 x3.GP4.t7 x5.A VDD.t10 sky130_fd_pr__pfet_01v8_lvt ad=2.9 pd=20.58 as=2.9 ps=20.58 w=10 l=0.35
X85 a_5645_5493# x1.nSEL1 VDD.t44 VDD.t43 sky130_fd_pr__pfet_01v8_hvt ad=0.0567 pd=0.69 as=0.16655 ps=1.39 w=0.42 l=0.15
X86 VSS.t47 a_5645_5493# x3.GN1.t1 VSS.t46 sky130_fd_pr__nfet_01v8 ad=0.1118 pd=1.04 as=0.182 ps=1.86 w=0.65 l=0.15
X87 VSS.t4 VDD.t82 VSS.t3 VSS.t2 sky130_fd_pr__nfet_01v8 ad=0.143 pd=1.62 as=0 ps=0 w=0.55 l=1.05
X88 x5.A x3.GN2 A2.t1 VSS.t31 sky130_fd_pr__nfet_01v8_lvt ad=2.32 pd=16.58 as=2.32 ps=16.58 w=8 l=0.35
X89 VDD.t32 x3.GN2 x3.GP2.t1 VDD.t31 sky130_fd_pr__pfet_01v8_hvt ad=0.26 pd=2.52 as=0.135 ps=1.27 w=1 l=0.15
X90 A2.t0 x3.GP2.t6 x5.A VDD.t17 sky130_fd_pr__pfet_01v8_lvt ad=2.9 pd=20.58 as=2.9 ps=20.58 w=10 l=0.35
X91 VDD.t36 a_5645_7149# x3.GN4.t0 VDD.t35 sky130_fd_pr__pfet_01v8_hvt ad=0.16655 pd=1.39 as=0.475 ps=2.95 w=1 l=0.15
X92 x5.GN select2.t7 VSS.t28 VSS.t27 sky130_fd_pr__nfet_01v8 ad=0.08775 pd=0.92 as=0.169 ps=1.82 w=0.65 l=0.15
X93 VSS.t59 select0.t8 x1.nSEL0 VSS.t58 sky130_fd_pr__nfet_01v8 ad=0.169 pd=1.82 as=0.08775 ps=0.92 w=0.65 l=0.15
X94 x3.GP2.t0 x3.GN2 VDD.t30 VDD.t29 sky130_fd_pr__pfet_01v8_hvt ad=0.135 pd=1.27 as=0.26 ps=2.52 w=1 l=0.15
X95 VDD.t34 x3.GN4.t8 x3.GP4.t0 VDD.t33 sky130_fd_pr__pfet_01v8_hvt ad=0.26 pd=2.52 as=0.135 ps=1.27 w=1 l=0.15
X96 x4.A x3.GN4.t9 A8.t0 VSS.t25 sky130_fd_pr__nfet_01v8_lvt ad=2.32 pd=16.58 as=2.32 ps=16.58 w=8 l=0.35
X97 VDD.t21 a_5645_6085# a_5645_5909# VDD.t20 sky130_fd_pr__pfet_01v8_hvt ad=0.0714 pd=0.76 as=0.0609 ps=0.71 w=0.42 l=0.15
X98 x3.GP3 x3.GN3 VDD.t12 VDD.t11 sky130_fd_pr__pfet_01v8_hvt ad=0.135 pd=1.27 as=0.26 ps=2.52 w=1 l=0.15
X99 VDD.t63 VSS.t79 VDD.t62 VDD.t61 sky130_fd_pr__pfet_01v8_hvt ad=0.2262 pd=2.26 as=0 ps=0 w=0.87 l=1.05
X100 a_5645_6085# select1.t8 VDD.t52 VDD.t51 sky130_fd_pr__pfet_01v8_hvt ad=0.1092 pd=1.36 as=0.0714 ps=0.76 w=0.42 l=0.15
X101 x1.nSEL0 select0.t9 VSS.t51 VSS.t50 sky130_fd_pr__nfet_01v8 ad=0.08775 pd=0.92 as=0.169 ps=1.82 w=0.65 l=0.15
X102 a_5645_6461# select1.t9 VDD.t50 VDD.t13 sky130_fd_pr__pfet_01v8_hvt ad=0.0609 pd=0.71 as=0.2279 ps=1.74 w=0.42 l=0.15
X103 A6.t3 x3.GP2.t7 x4.A VDD.t7 sky130_fd_pr__pfet_01v8_lvt ad=2.9 pd=20.58 as=2.9 ps=20.58 w=10 l=0.35
R0 VSS.n163 VSS.n162 587674
R1 VSS.n219 VSS.n218 153375
R2 VSS.n119 VSS.n112 117542
R3 VSS.n177 VSS.n176 71206.2
R4 VSS.n176 VSS.n175 64736.2
R5 VSS.n164 VSS.n9 16580.8
R6 VSS.n168 VSS.n108 11744.7
R7 VSS.n174 VSS.n108 11744.7
R8 VSS.n168 VSS.n109 11744.7
R9 VSS.n174 VSS.n109 11744.7
R10 VSS.n116 VSS.n106 11744.7
R11 VSS.n178 VSS.n106 11744.7
R12 VSS.n116 VSS.n107 11744.7
R13 VSS.n178 VSS.n107 11744.7
R14 VSS.n267 VSS.n22 11744.7
R15 VSS.n263 VSS.n22 11744.7
R16 VSS.n267 VSS.n23 11744.7
R17 VSS.n263 VSS.n23 11744.7
R18 VSS.n281 VSS.n10 11744.7
R19 VSS.n277 VSS.n10 11744.7
R20 VSS.n281 VSS.n11 11744.7
R21 VSS.n277 VSS.n11 11744.7
R22 VSS.n274 VSS.n16 11744.7
R23 VSS.n270 VSS.n16 11744.7
R24 VSS.n274 VSS.n17 11744.7
R25 VSS.n270 VSS.n17 11744.7
R26 VSS.n256 VSS.n28 11744.7
R27 VSS.n256 VSS.n29 11744.7
R28 VSS.n260 VSS.n29 11744.7
R29 VSS.n260 VSS.n28 11744.7
R30 VSS.n131 VSS.n130 11744.7
R31 VSS.n127 VSS.n126 11744.7
R32 VSS.n130 VSS.n127 11744.7
R33 VSS.n160 VSS.n120 11744.7
R34 VSS.n156 VSS.n121 11744.7
R35 VSS.n160 VSS.n121 11744.7
R36 VSS.n144 VSS.n143 11744.7
R37 VSS.n140 VSS.n139 11744.7
R38 VSS.n143 VSS.n140 11744.7
R39 VSS.n284 VSS.n4 11744.7
R40 VSS.n284 VSS.n5 11744.7
R41 VSS.n7 VSS.n4 11744.7
R42 VSS.n163 VSS.n112 10428.2
R43 VSS.n164 VSS.n117 7573.12
R44 VSS.n117 VSS.t73 7065.1
R45 VSS.n177 VSS.t74 7065.1
R46 VSS.t73 VSS.n113 6710.74
R47 VSS.n113 VSS.t74 6710.74
R48 VSS.n167 VSS.n165 6647.5
R49 VSS.n276 VSS.n275 6049.9
R50 VSS.n167 VSS.t75 6006.85
R51 VSS.n175 VSS.t65 6006.85
R52 VSS.n262 VSS.n261 6004.3
R53 VSS.n283 VSS.n282 5972.7
R54 VSS.n269 VSS.n268 5963.12
R55 VSS.t75 VSS.n166 5705.56
R56 VSS.n166 VSS.t65 5705.56
R57 VSS.n165 VSS.n112 4796.58
R58 VSS.n164 VSS.n163 3666.67
R59 VSS.n118 VSS.n9 3385.09
R60 VSS.n15 VSS.n9 3361.58
R61 VSS.n27 VSS.n21 3305.56
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
R610 select2.n0 select2.t4 374.202
R611 select2.n2 select2.t1 212.081
R612 select2.n1 select2.t6 212.081
R613 select2.n3 select2.n2 183.441
R614 select2.n2 select2.t7 139.78
R615 select2.n1 select2.t5 139.78
R616 select2.n2 select2.n1 61.346
R617 select2.n8 select2.n7 12.4093
R618 select2 select2.n3 11.4331
R619 select2.n7 select2.n6 9.10647
R620 select2.n7 select2.n4 8.98648
R621 select2.n3 select2 5.6325
R622 select2.n4 select2 5.02323
R623 select2.n6 select2.n5 3.1748
R624 select2.n8 select2.n0 2.10165
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
