psychogenic/analogmuxkit/xschem/simulation/tb_passgaterdson.spice

** sch_path: /home/ttuser/vmswap/analogmuxkit/xschem/tb_passgaterdson.sch
**.subckt tb_passgaterdson
x1 IN EN nEN OUT VCC VSS passgate
V1 VCC VSS 1.8
x2 nEN EN VCC VSS not W_N=1 L_N=0.15 W_P=2 L_P=0.15 m=1
V2 IN VSS sin(0.9 0.9 1Meg)
V3 EN VSS PULSE(1.8 1.8 10u 10n 10n 5u 10u)
V4 VSS GND 0
x3 IN EN nEN OUT_PX VCC VSS passgate_parax
I0 OUT VSS 500u
I1 OUT_PX VSS 500u
**** begin user architecture code

.param mc_mm_switch=0
.param mc_pr_switch=0
.include /home/ttuser/pdk/sky130A/libs.tech/ngspice/corners/tt.spice
.include /home/ttuser/pdk/sky130A/libs.tech/ngspice/r+c/res_typical__cap_typical.spice
.include /home/ttuser/pdk/sky130A/libs.tech/ngspice/r+c/res_typical__cap_typical__lin.spice
.include /home/ttuser/pdk/sky130A/libs.tech/ngspice/corners/tt/specialized_cells.spice

**** end user architecture code
**.ends

* expanding   symbol:  passgate.sym # of pins=6
** sym_path: /home/ttuser/vmswap/analogmuxkit/xschem/passgate.sym
** sch_path: /home/ttuser/vmswap/analogmuxkit/xschem/passgate.sch
.subckt passgate A GN GP Z VDD VSS
*.ipin GN
*.ipin VDD
*.ipin VSS
*.ipin GP
*.iopin A
*.iopin Z
XM1 Z GN A VSS sky130_fd_pr__nfet_01v8_lvt L=0.35 W=8 nf=1 ad='int((nf+1)/2) * W/nf * 0.29' as='int((nf+2)/2) * W/nf * 0.29' pd='2*int((nf+1)/2) * (W/nf + 0.29)'
+ ps='2*int((nf+2)/2) * (W/nf + 0.29)' nrd='0.29 / W' nrs='0.29 / W' sa=0 sb=0 sd=0 mult=2 m=2
XM3 Z GP A VDD sky130_fd_pr__pfet_01v8_lvt L=0.35 W=10 nf=1 ad='int((nf+1)/2) * W/nf * 0.29' as='int((nf+2)/2) * W/nf * 0.29' pd='2*int((nf+1)/2) * (W/nf + 0.29)'
+ ps='2*int((nf+2)/2) * (W/nf + 0.29)' nrd='0.29 / W' nrs='0.29 / W' sa=0 sb=0 sd=0 mult=2 m=2
.ends


* expanding   symbol:  sky130_tests/not.sym # of pins=2
** sym_path: /home/ttuser/pdk/sky130A/libs.tech/xschem/sky130_tests/not.sym
** sch_path: /home/ttuser/pdk/sky130A/libs.tech/xschem/sky130_tests/not.sch
.subckt not y a VCCPIN VSSPIN     W_N=1 L_N=0.15 W_P=2 L_P=0.15
*.opin y
*.ipin a
XM1 y a VSSPIN VSSPIN sky130_fd_pr__nfet_01v8 L=L_N W=W_N nf=1 ad='int((nf+1)/2) * W/nf * 0.29' as='int((nf+2)/2) * W/nf * 0.29' pd='2*int((nf+1)/2) * (W/nf + 0.29)'
+ ps='2*int((nf+2)/2) * (W/nf + 0.29)' nrd='0.29 / W' nrs='0.29 / W' sa=0 sb=0 sd=0 mult=1 m=1
XM2 y a VCCPIN VCCPIN sky130_fd_pr__pfet_01v8 L=L_P W=W_P nf=1 ad='int((nf+1)/2) * W/nf * 0.29' as='int((nf+2)/2) * W/nf * 0.29' pd='2*int((nf+1)/2) * (W/nf + 0.29)'
+ ps='2*int((nf+2)/2) * (W/nf + 0.29)' nrd='0.29 / W' nrs='0.29 / W' sa=0 sb=0 sd=0 mult=1 m=1
.ends


* expanding   symbol:  passgate_parax.sym # of pins=6
** sym_path: /home/ttuser/vmswap/analogmuxkit/xschem/passgate.sym
.include /home/ttuser/vmswap/analogmuxkit/xschem/extracted/passgate_parax.spice
.GLOBAL GND
**** begin user architecture code


* ngspice commands
* .options savecurrents

.control
dc V2 0 1.8 0.01

* plot (v(in) - v(out_px)) / 300u, (v(in) - v(out)) / 300u,
write tb_passgaterdson.raw
quit 0
.endc



**** end user architecture code
.end
